theparadoxShin/aura/(commit log)

2026-09-13 add state led on equipement and document the readme
2026-09-13 complete some ressources and bug fix of the dashboard
    [sketch.ino]
